Lawton-Jones17/Project-C.A.R.S/ProjectCARS/ProjectCARS.kicad_pcb

## KiCad design irrigation/PowerManagement.kicad_sch

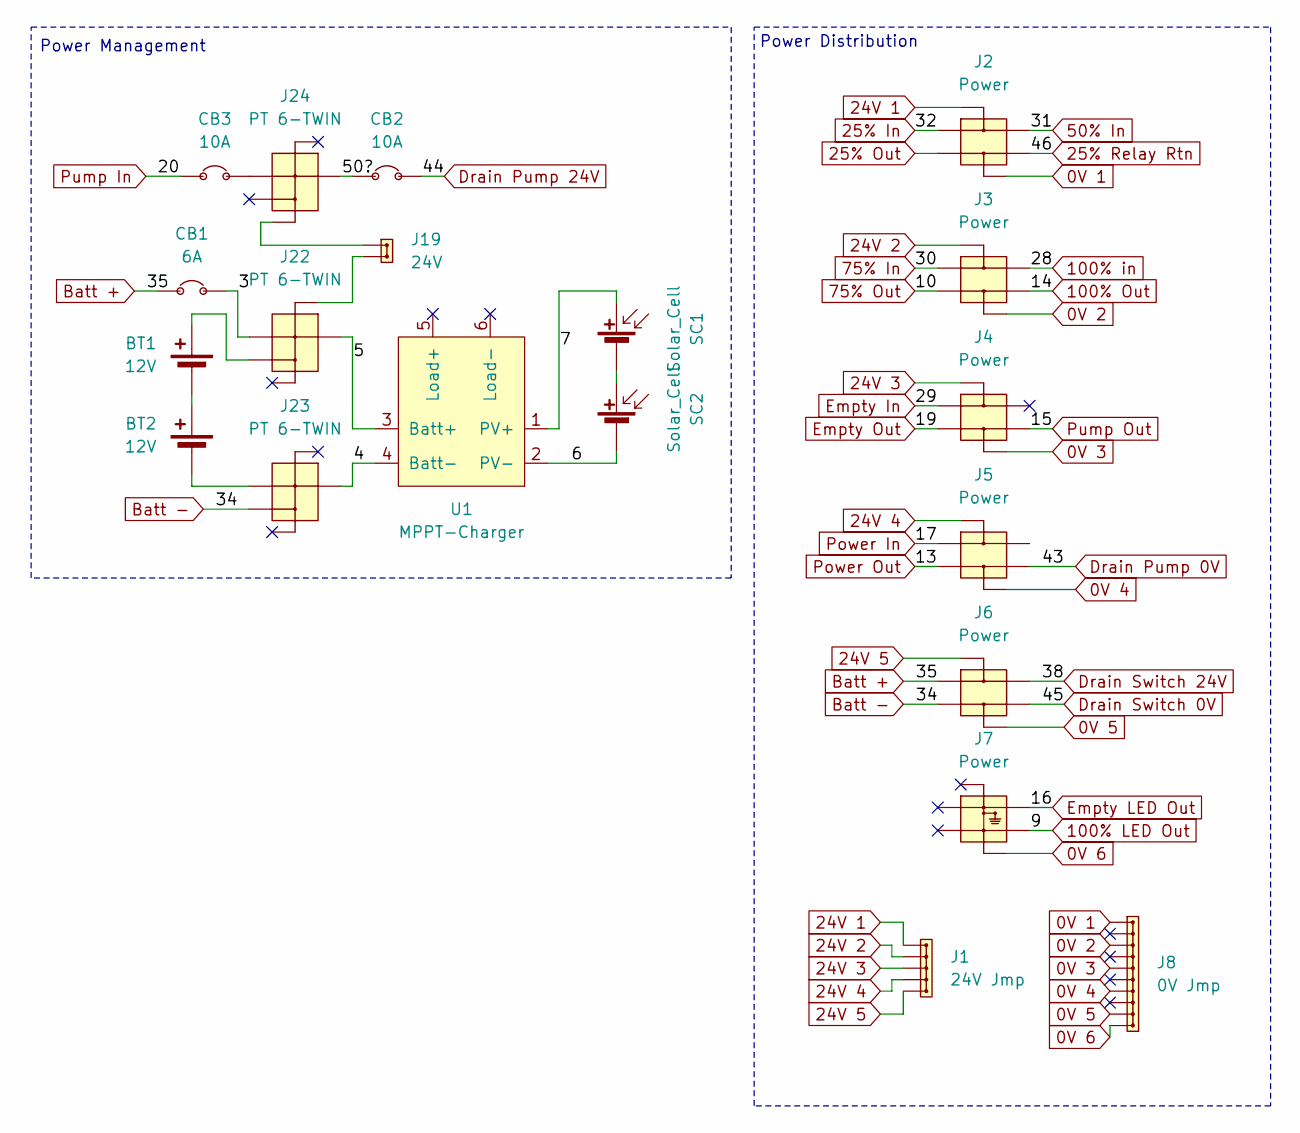
[picture p19: schematic PowerManagement.kicad_sch]

Parts:
BT1, BT2: 12V
CB1: 6A
CB2, CB3: 10A
J1: 24V Jmp
J2, J3, J4, J5, J6, J7: Power
J8: 0V Jmp
J19: 24V
J22, J23, J24: PT 6-TWIN
SC1, SC2: Solar_Cell
U1: MPPT-Charger

Connections:
0V 1: J2., J8.
0V 2: J3., J8.
0V 3: J4., J8.
0V 4: J5., J8.
0V 5: J6., J8.
0V 6: J7., J8.
3: CB1., J22.
4: J23., U1.4 (Batt-)
5: J22., U1.3 (Batt+)
6: SC2.2 (-), U1.2 (PV-)
7: SC1.1 (+), U1.1 (PV+)
24V 1: J1., J2.
24V 2: J1., J3.
24V 3: J1., J4.
24V 4: J1., J5.
24V 5: J1., J6.
25% In: J2.
25% Out: J2.
25% Relay Rtn: J2.
50% In: J2.
50?: CB2., J24.
75% In: J3.
75% Out: J3.
100% LED Out: J7.
100% Out: J3.
100% in: J3.
Batt +: CB1., J6.
Batt -: J6., J23.
Drain Pump 0V: J5.
Drain Pump 24V: CB2.
Drain Switch 0V: J6.
Drain Switch 24V: J6.
Empty In: J4.
Empty LED Out: J7.
Empty Out: J4.
unnamed: BT1.1 (+), J22.
unnamed: BT1.2 (-), BT2.1 (+)
unnamed: BT2.2 (-), J23.
unnamed: CB3., J24.
unnamed: J19., J22., J24.
unnamed: SC1.2 (-), SC2.1 (+)
Power In: J5.
Power Out: J5.
Pump In: CB3.
Pump Out: J4.

Notes on the sheet:
Power Distribution
Power Management
