Lawton-Jones17/Project-C.A.R.S/ProjectCARS/ProjectCARS.kicad_pcb

## KiCad design irrigation/irrigation.kicad_sch

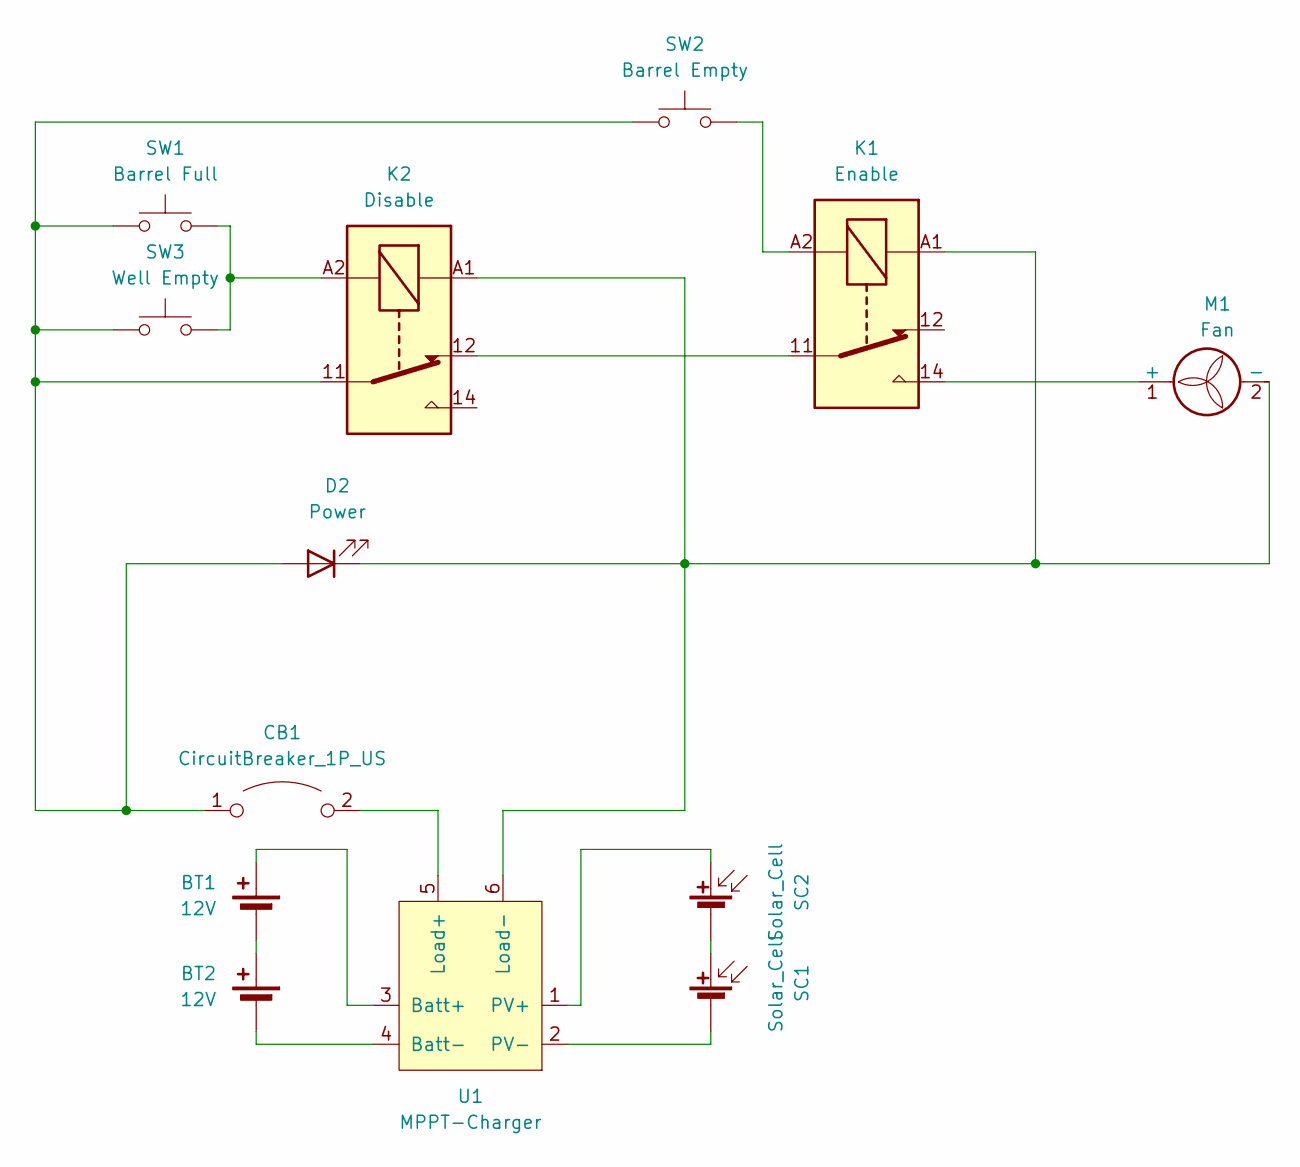
[picture p20: schematic irrigation.kicad_sch]

Parts:
BT1, BT2: 12V
CB1: CircuitBreaker_1P_US
D2: Power
K1: Enable; Relay_SPDT_Finder_40.31
K2: Disable; Relay_SPDT_Finder_40.31
M1: Fan
SC1, SC2: Solar_Cell
SW1: Barrel Full
SW2: Barrel Empty
SW3: Well Empty
U1: MPPT-Charger

Connections:
unnamed: BT1.1 (+), U1.3 (Batt+)
unnamed: BT1.2 (-), BT2.1 (+)
unnamed: BT2.2 (-), U1.4 (Batt-)
unnamed: CB1.1, D2.2 (A), K2.11, SW1.1, SW2.1, SW3.1
unnamed: CB1.2, U1.5 (Load+)
unnamed: D2.1 (K), K1.A1, K2.A1, M1.2 (-), U1.6 (Load-)
unnamed: K1.11, K2.12
unnamed: K1.14, M1.1 (+)
unnamed: K1.A2, SW2.2
unnamed: K2.A2, SW1.2, SW3.2
unnamed: SC1.1 (+), SC2.2 (-)
unnamed: SC1.2 (-), U1.2 (PV-)
unnamed: SC2.1 (+), U1.1 (PV+)
