Lawton-Jones17/Project-C.A.R.S/(commit log)

2026-04-24 Steering Logic
2026-04-27 Filtered Steering Logic (-90 <-> 90 range)
2026-04-28 Wireless Communication and Steering updates
2026-04-28 Implemented Brake Pedal (Reverse)
    [RovArd_ForwardPedal.ino, RovESP_ForwardPedal.ino]
2026-04-28 Rover Schematic
    [ProjectCARS.kicad_sch]
2026-05-05 New Schematics/Clean Up Comments
    [ProjectCARS.kicad_sch]
